Jaycar-Electronics/IR-Remote-Learner/images/copper.jpg

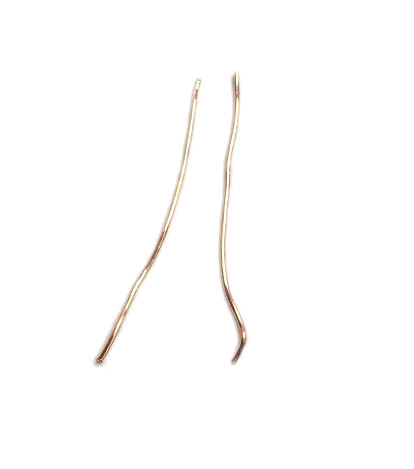
images/copper.jpg
