Jaycar-Electronics/IR-Remote-Learner/images/rails.jpg

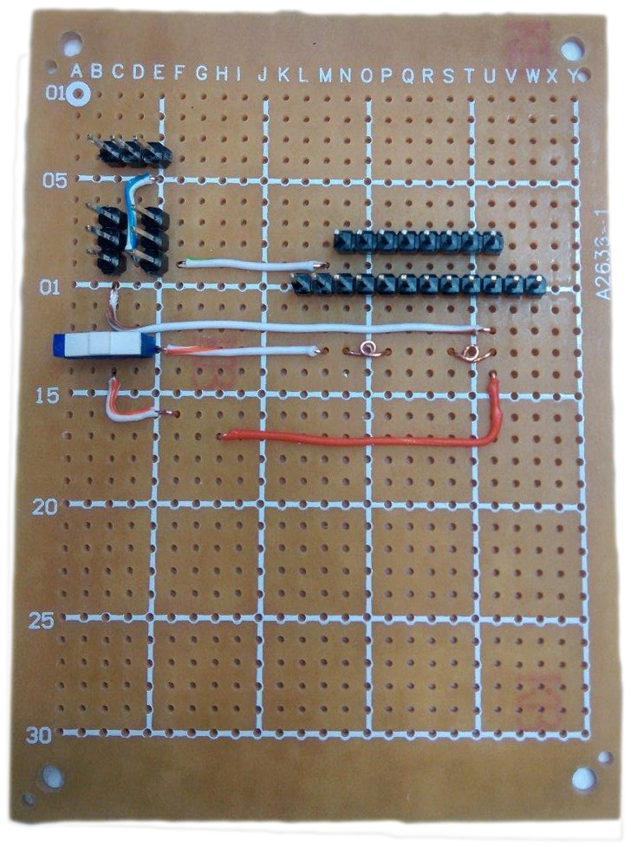
images/rails.jpg
