Jaycar-Electronics/IR-Remote-Learner/images/receiver.jpg

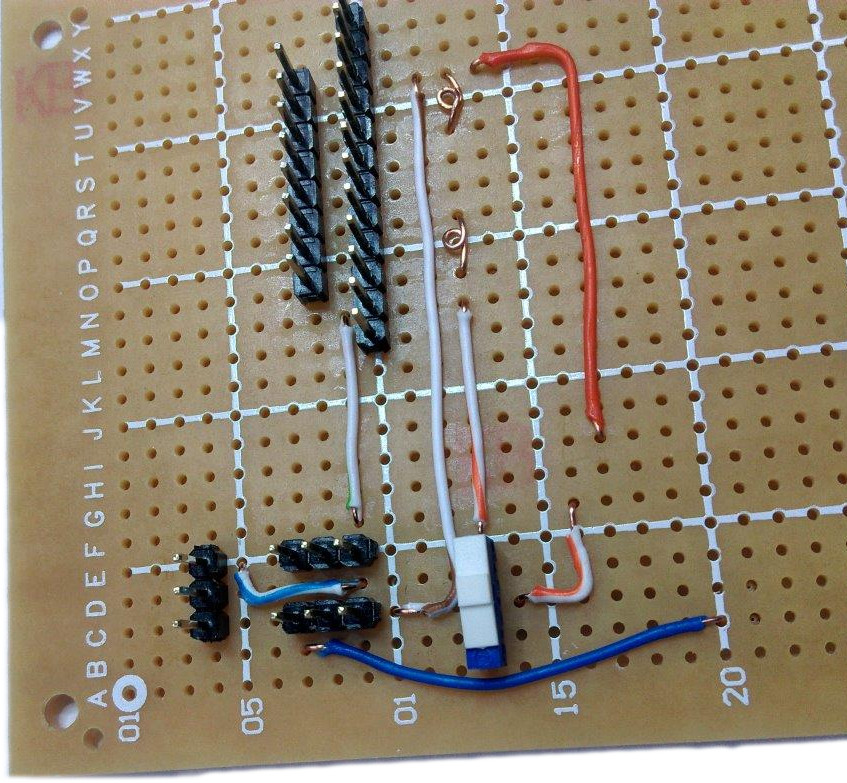
images/receiver.jpg
