Jaycar-Electronics/IR-Remote-Learner/images/transmitter.jpg

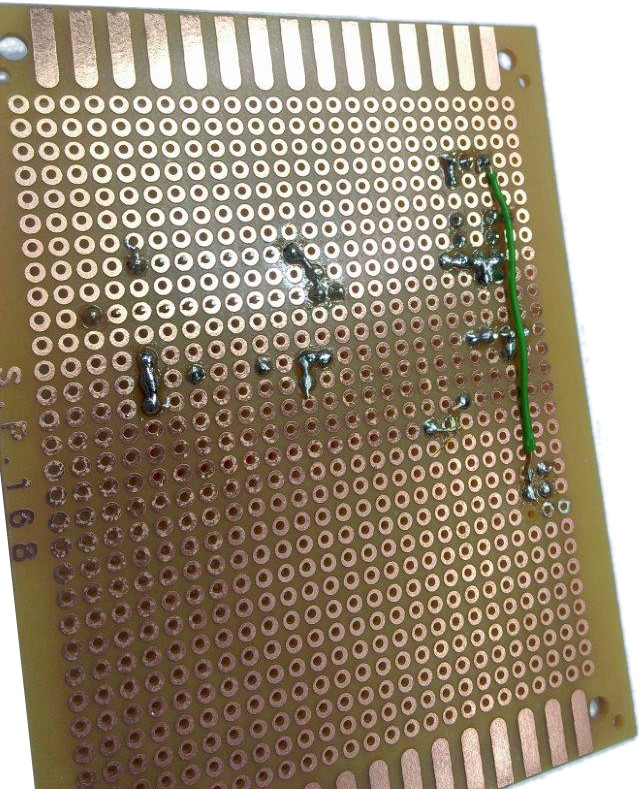
images/transmitter.jpg
