Jaycar-Electronics/IR-Remote-Learner/images/assemble.jpg

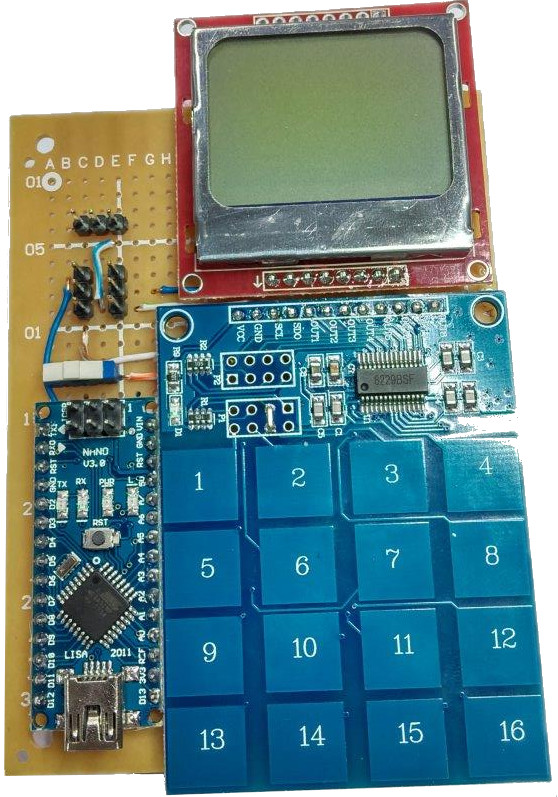
images/assemble.jpg
